AnnaLukose/EEE3088F-Project-2025-Group-37/ANNA LUKOSE (LKSANN001)/README.md

This folder relates to the following subsections of the power sub-system:
* Power switch (toggle switch)
* Type C connector and negotiator which negotiates 9V out
* 5V Out Boost converter with >90% efficency at 1A load
* 3V3 Out Buck converter with >90% efficency at 300mA load
* 2 External Load switches

To view the schematic focusing on these specific sections open: LKSANN001-Schematic.png

Alternatively, to view and edit the actual schematic:
1) Copy the schematic file onto your local system:
```
wget "https://github.com/AnnaLukose/EEE3088F-Project-2025-Group-37/blob/main/ANNA%20LUKOSE%20(LKSANN001)/LKSANN001.kicad_sch"
```
Or use any other relevant means

2) Open the file using KiCad's Schematic Editor
