AnnaLukose/EEE3088F-Project-2025-Group-37/ANNA LUKOSE (LKSANN001)/LKSANN001-Schematic.png

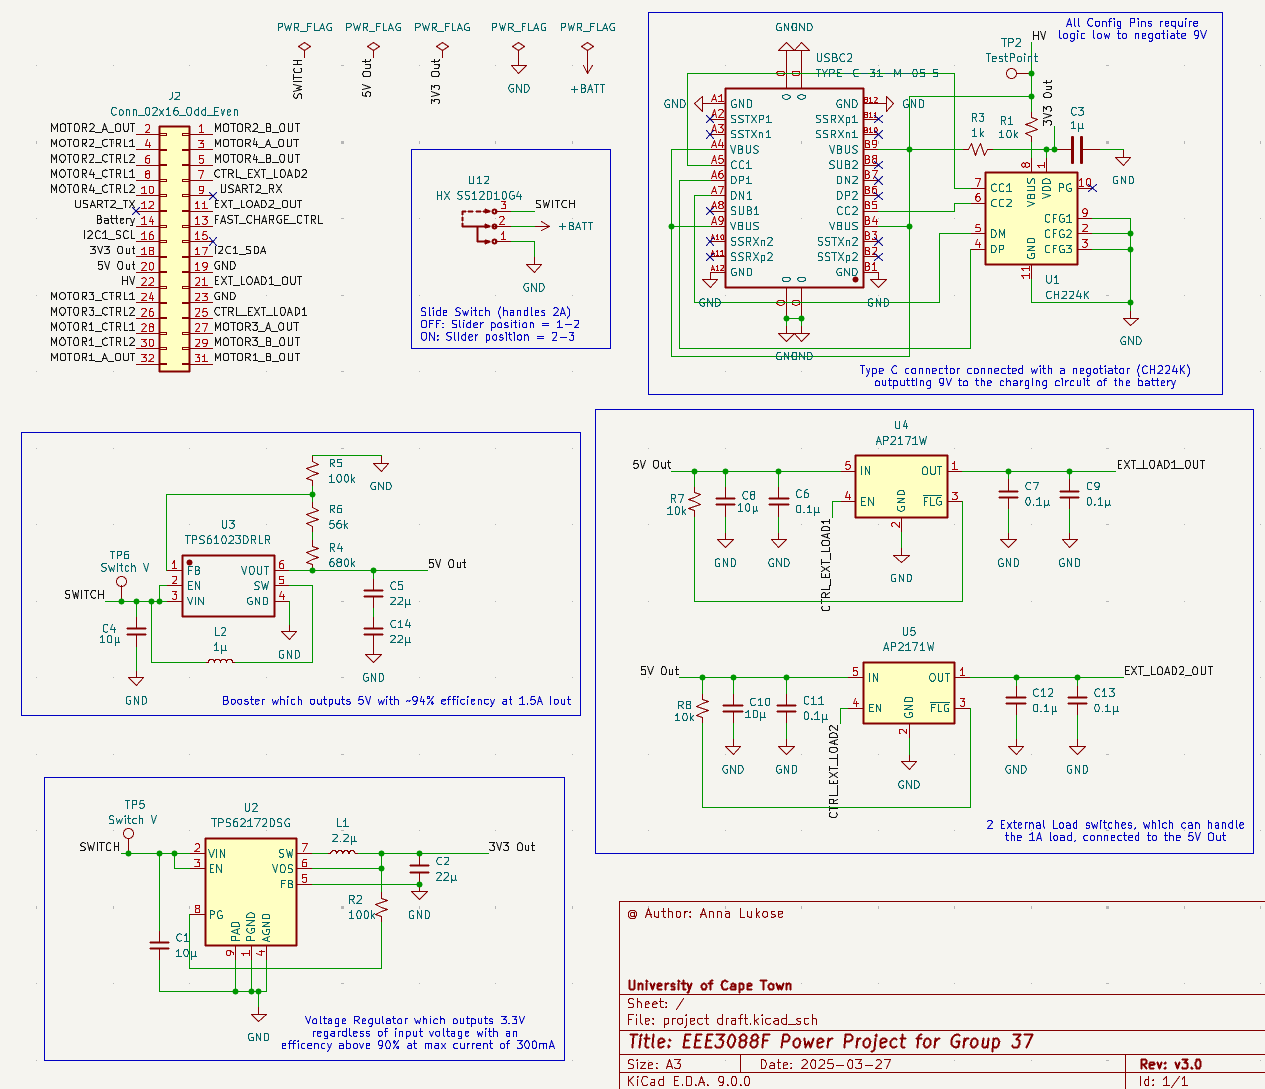
ANNA LUKOSE (LKSANN001)/LKSANN001-Schematic.png
