AnnaLukose/EEE3088F-Project-2025-Group-37/KICAD FILES/jlcpcb/production_files/EEE3088F_Project_JLCPCBBOM_LKSANN001_SNGMIS005.png

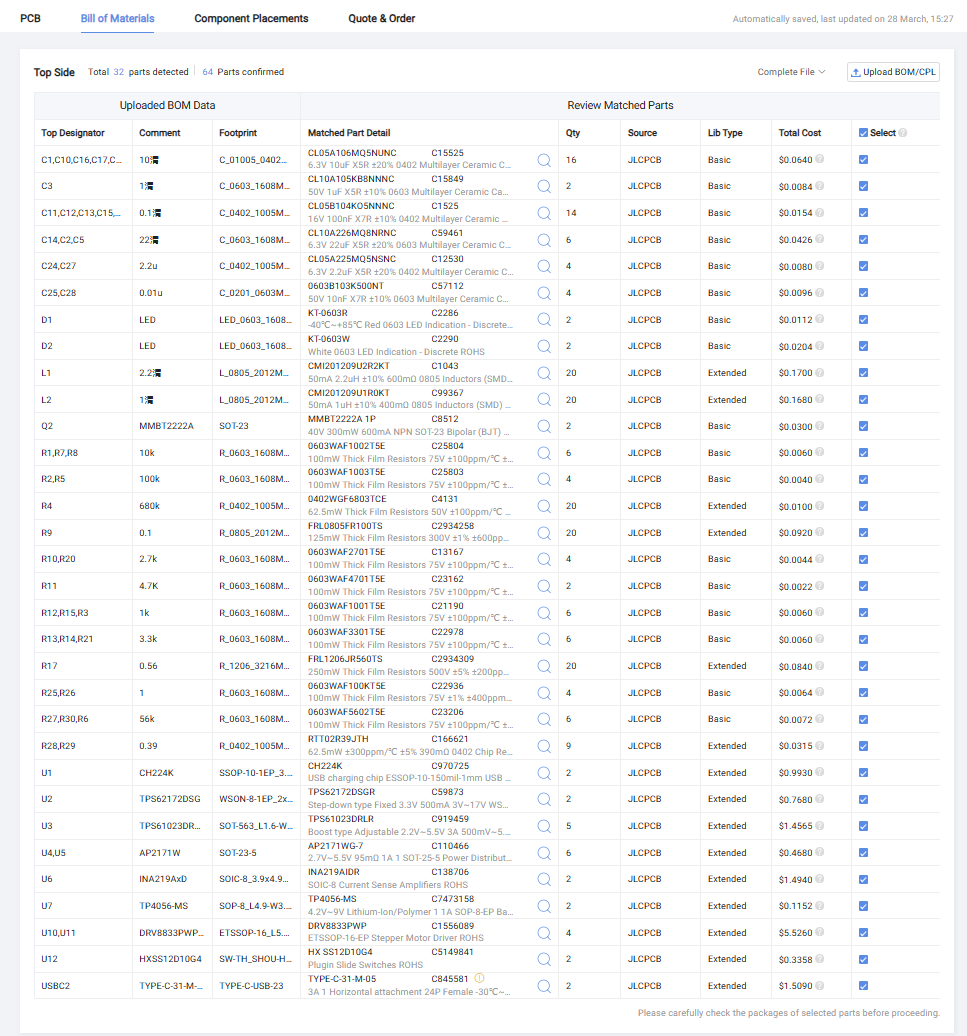
KICAD FILES/jlcpcb/production_files/EEE3088F_Project_JLCPCBBOM_LKSANN001_SNGMIS005.png
