AnnaLukose/EEE3088F-Project-2025-Group-37/KICAD FILES/jlcpcb/production_files/JLCPCB Quote.png

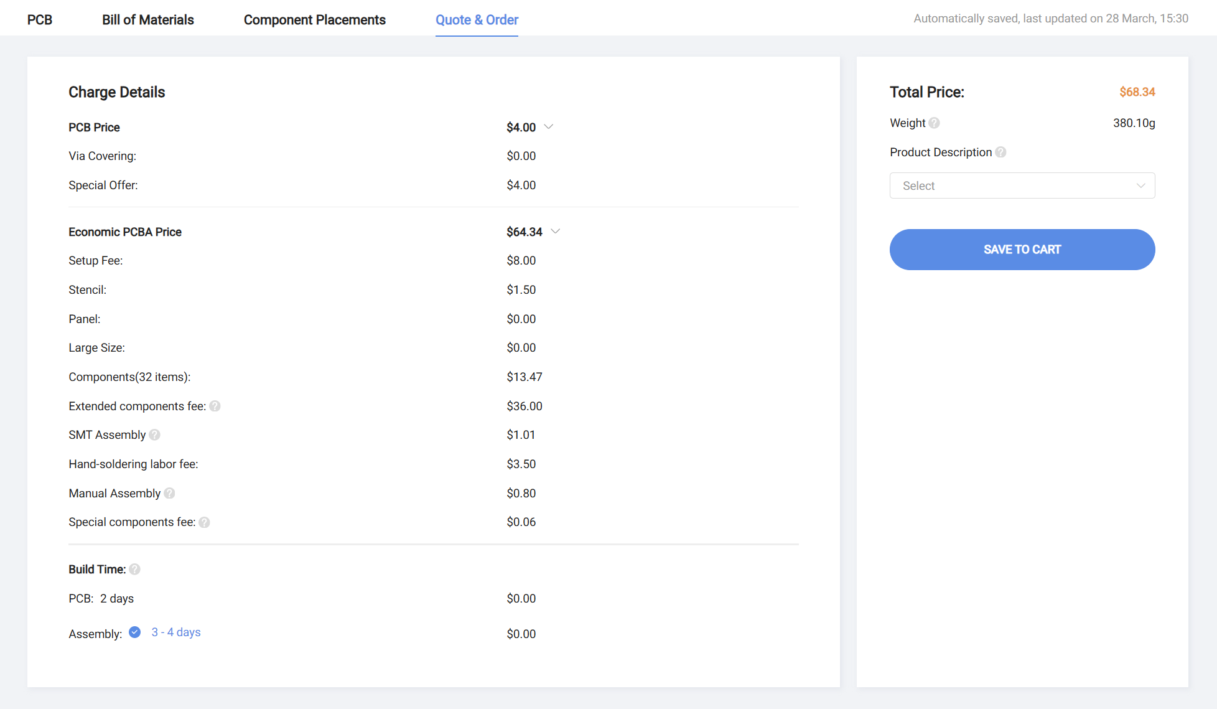
KICAD FILES/jlcpcb/production_files/JLCPCB Quote.png
