AnnaLukose/EEE3088F-Project-2025-Group-37/Schematic.pdf

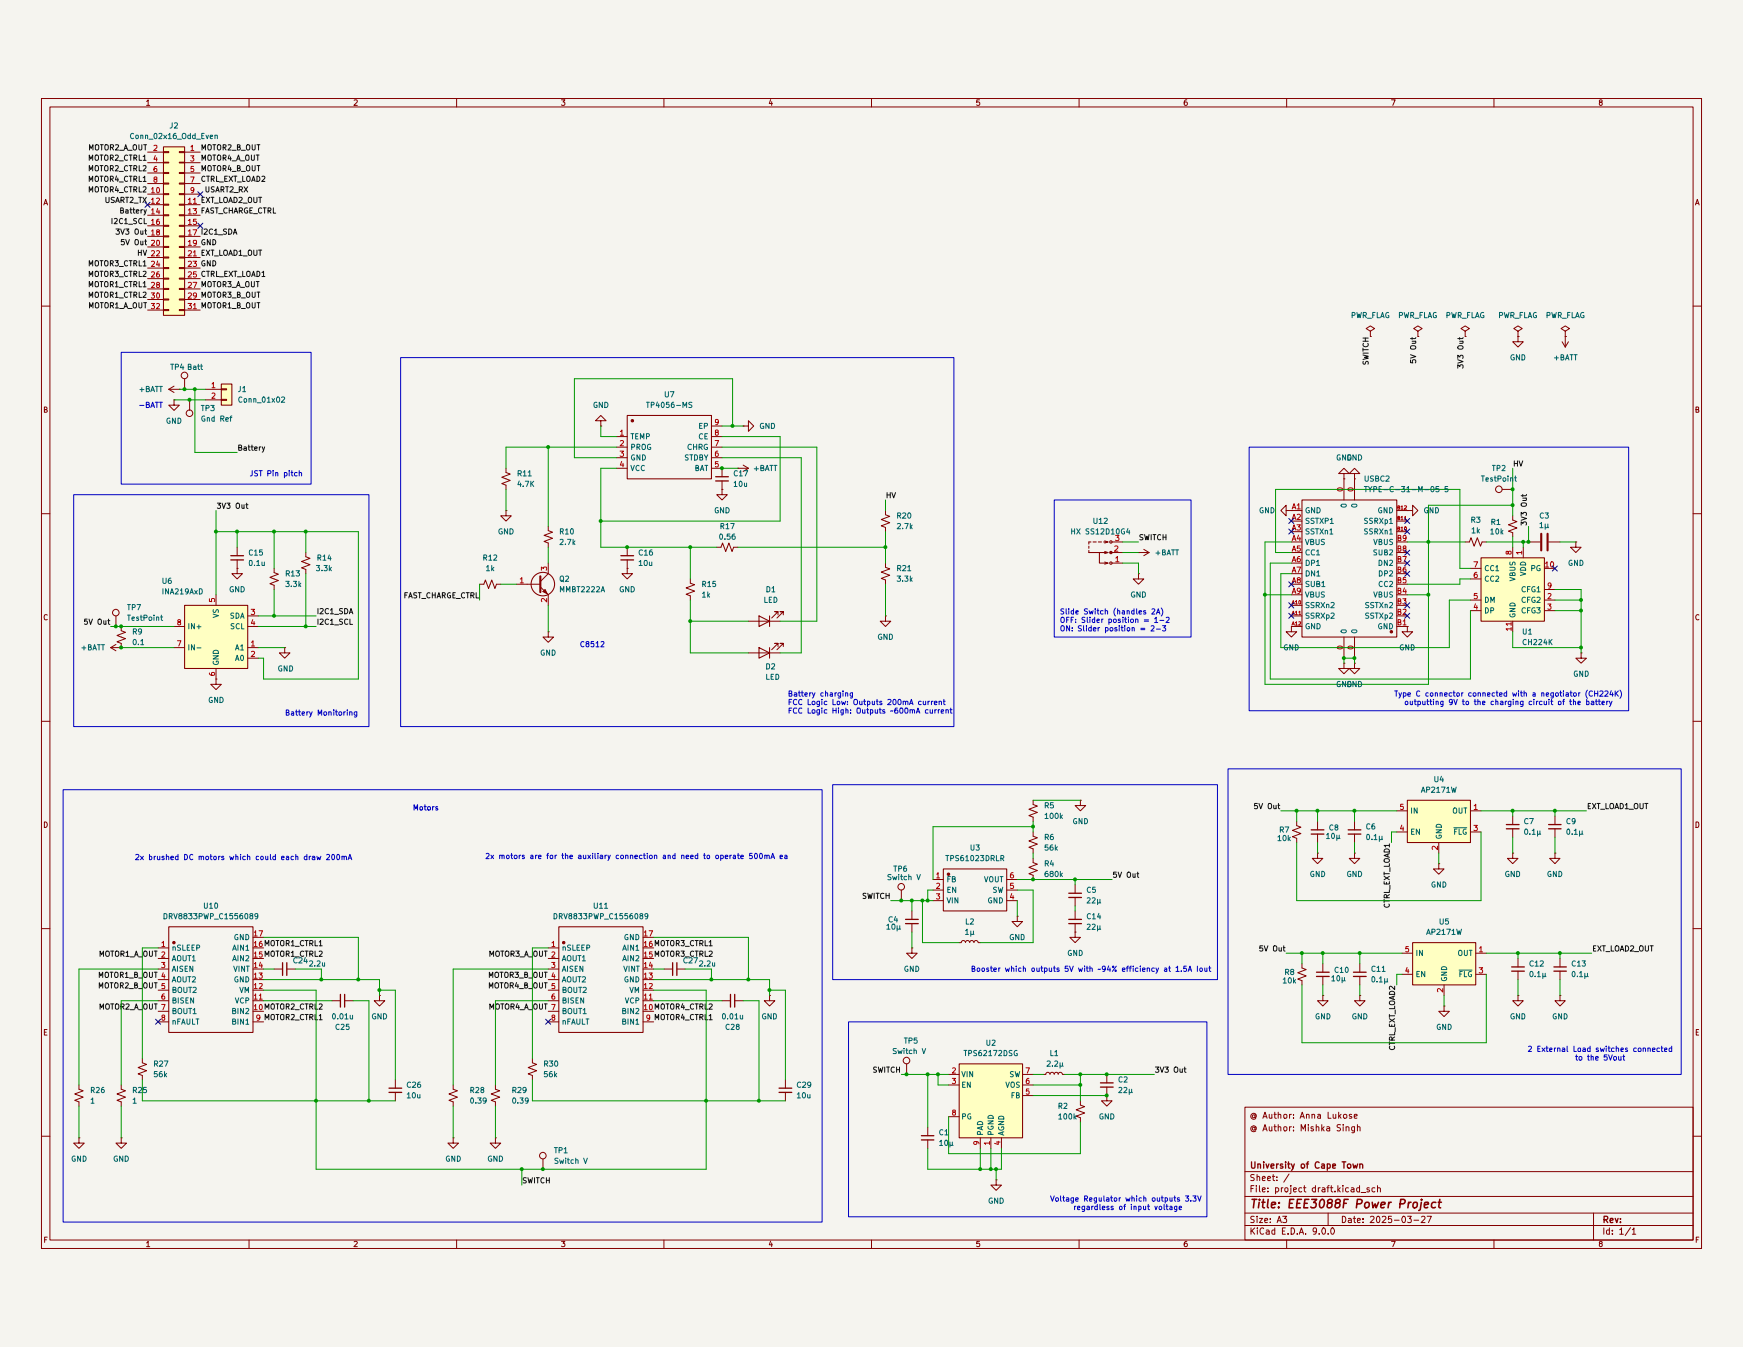
[picture p6: page 1]
