AnnaLukose/EEE3088F-Project-2025-Group-37/MISHKA SINGH (SNGMIS005)/schematic.pdf

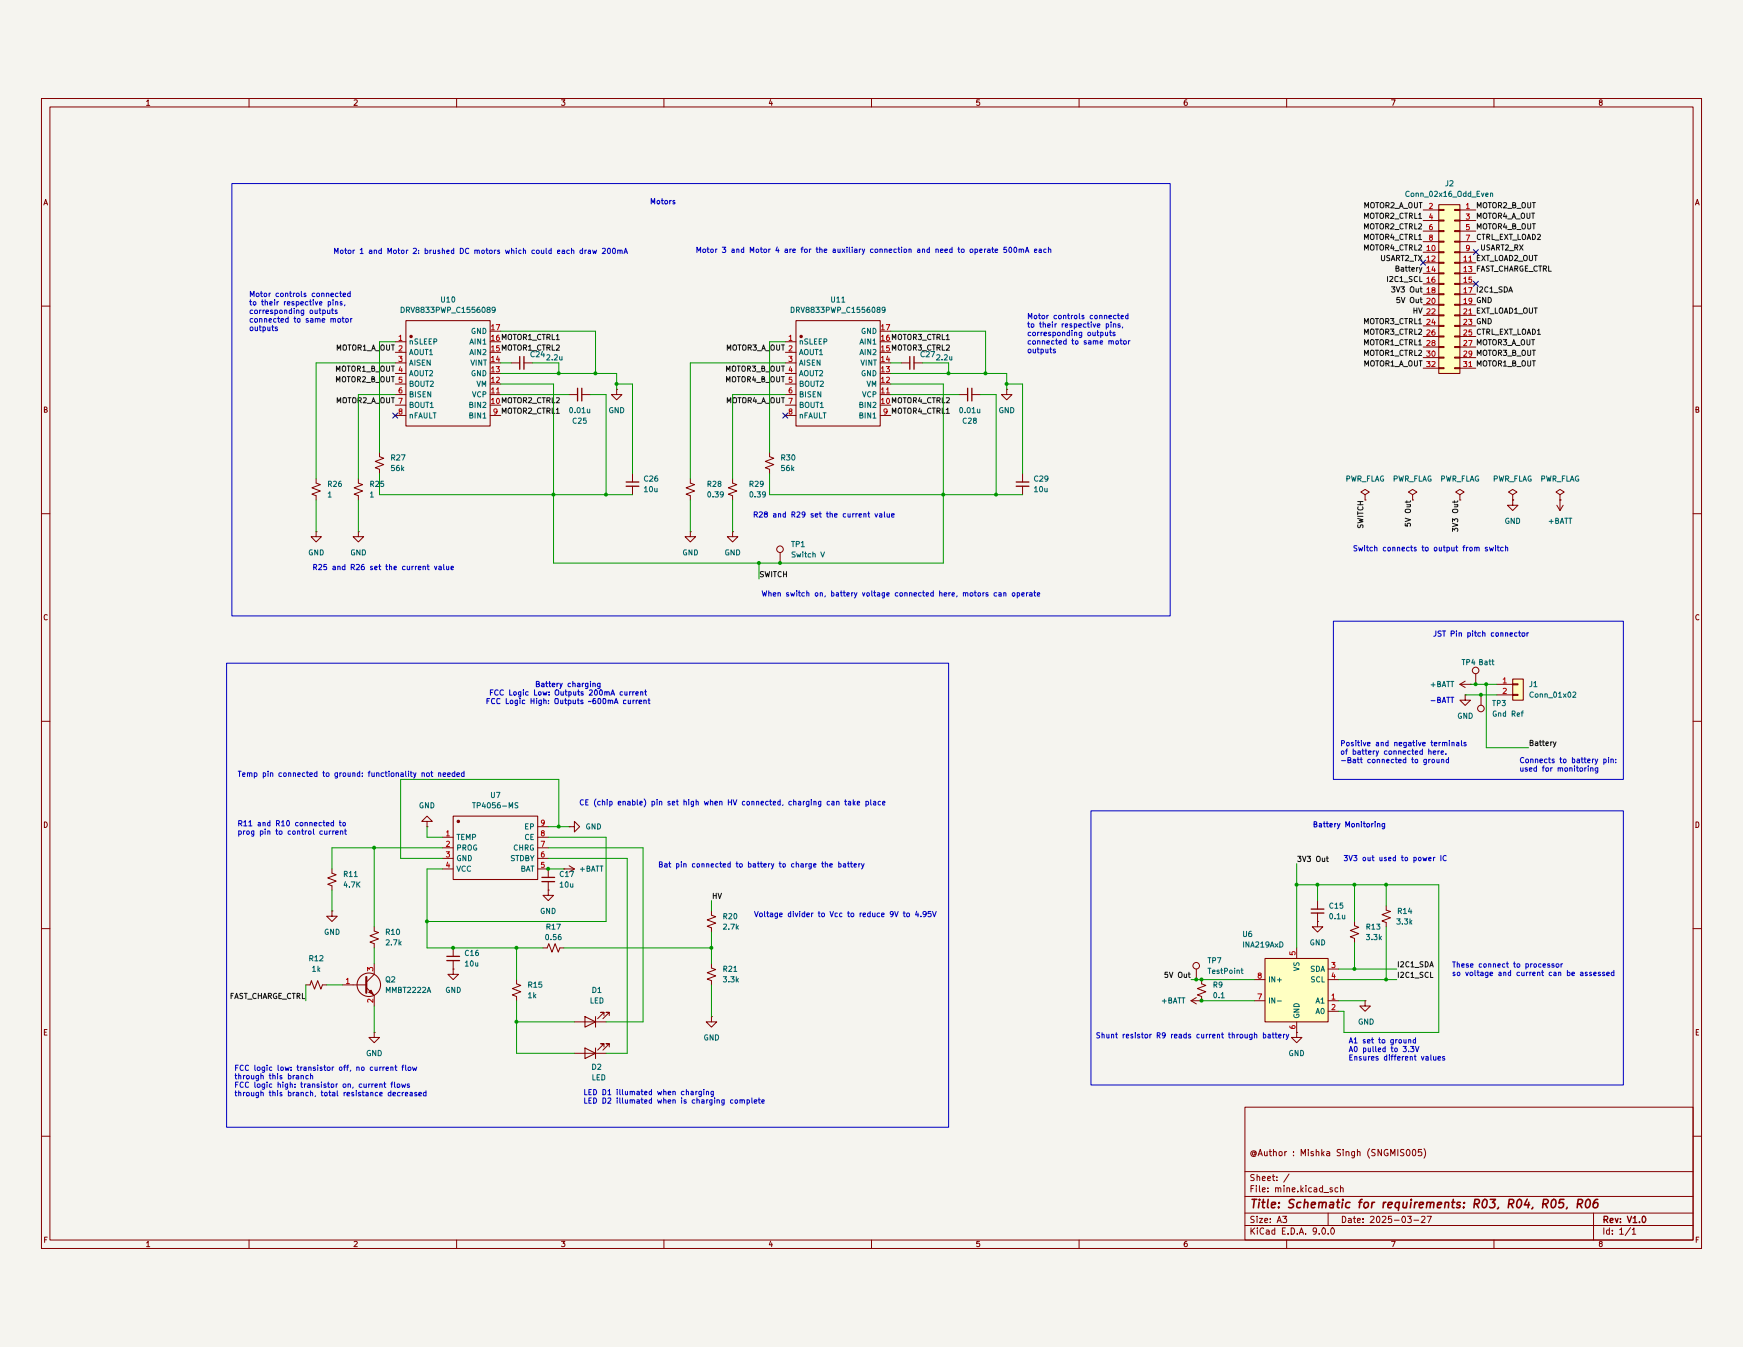
[picture p7: page 1]
