AnnaLukose/EEE3088F-Project-2025-Group-37/MISHKA SINGH (SNGMIS005)/mine/mine.kicad_pcb

## KiCad design KiCad/motor_trotten/motor_trotten.kicad_sch

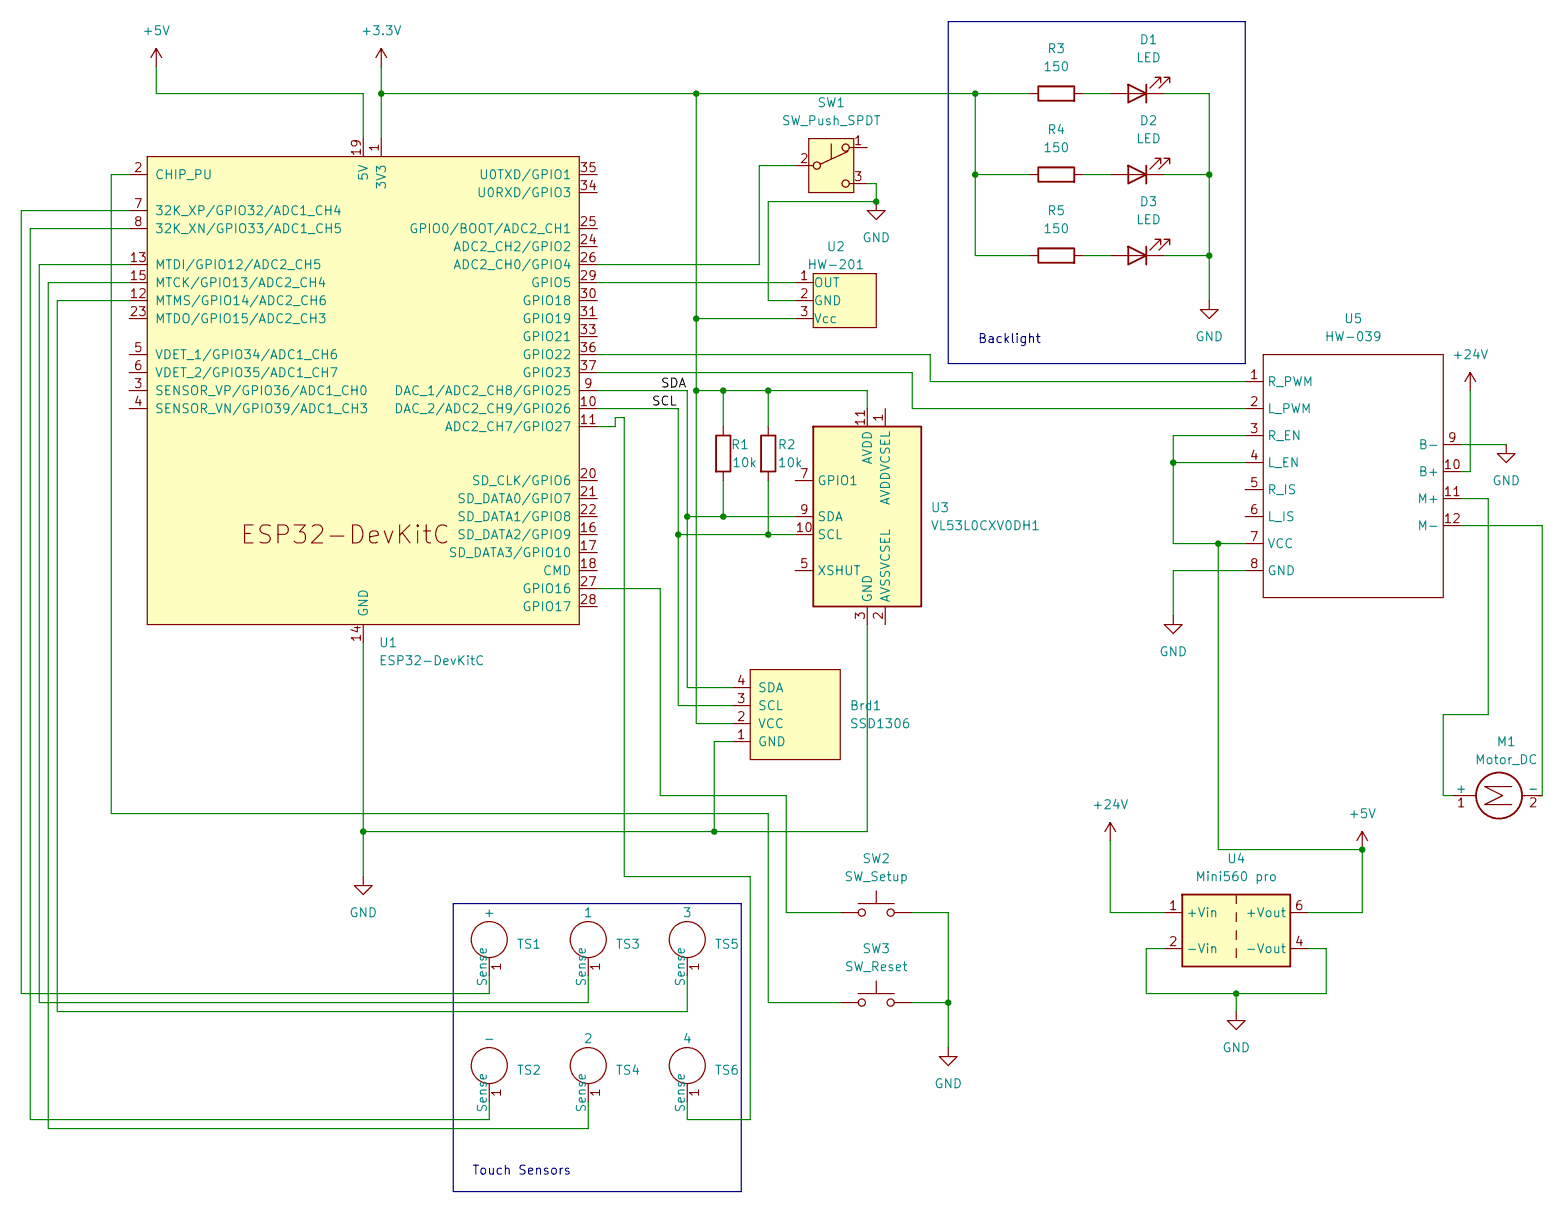
[picture p8: schematic motor_trotten.kicad_sch]

Parts:
Brd1: SSD1306
D1, D2, D3: LED
M1: Motor_DC
R1, R2: 10k
R3, R4, R5: 150
SW1: SW_Push_SPDT
SW2: SW_Setup
SW3: SW_Reset
TS1, TS2, TS3, TS4, TS5, TS6: (no value)
U1: ESP32-DevKitC
U2: HW-201
U3: VL53L0CXV0DH1; ST_VL53L1x
U4: Mini560 pro; Converter_DCDC_TRACO_TBA2-xxxx_Single_THT
U5: HW-039

Connections:
+3.3V: Brd1.2 (VCC), R1.1, R2.1, R3.1, R4.1, R5.1, U1.1 (3V3), U2.3 (Vcc), U3.11 (AVDD)
+5V: U1.19 (5V), U4.6 (+Vout), U5.3 (R_EN), U5.4 (L_EN), U5.7 (VCC)
+24V: U4.1 (+Vin), U5.10 (B+)
GND: Brd1.1 (GND), D1.1 (K), D2.1 (K), D3.1 (K), SW1.3 (C), SW2.2, SW3.2, U1.14 (GND), U1.32 (GND), U1.38 (GND), U2.2 (GND), U3.3 (GND), U3.4 (GND), U3.6 (GND), U3.12 (GND), U4.2 (-Vin), U4.4 (-Vout), U5.8 (GND), U5.9 (B-)
unnamed: D1.2 (A), R3.2
unnamed: D2.2 (A), R4.2
unnamed: D3.2 (A), R5.2
unnamed: M1.1 (+), U5.11 (M+)
unnamed: M1.2 (-), U5.12 (M-)
unnamed: SW1.2 (B), U1.26 (ADC2_CH0/GPIO4)
unnamed: SW2.1, U1.27 (GPIO16)
unnamed: SW3.1, U1.2 (CHIP_PU)
unnamed: TS1.1, U1.7 (32K_XP/GPIO32/ADC1_CH4)
unnamed: TS2.1, U1.8 (32K_XN/GPIO33/ADC1_CH5)
unnamed: TS3.1, U1.13 (MTDI/GPIO12/ADC2_CH5)
unnamed: TS4.1, U1.15 (MTCK/GPIO13/ADC2_CH4)
unnamed: TS5.1, U1.12 (MTMS/GPIO14/ADC2_CH6)
unnamed: TS6.1, U1.11 (ADC2_CH7/GPIO27)
unnamed: U1.29 (GPIO5), U2.1 (OUT)
unnamed: U1.36 (GPIO22), U5.1 (R_PWM)
unnamed: U1.37 (GPIO23), U5.2 (L_PWM)
SCL: Brd1.3 (SCL), R2.2, U1.10 (DAC_2/ADC2_CH9/GPIO26), U3.10 (SCL)
SDA: Brd1.4 (SDA), R1.2, U1.9 (DAC_1/ADC2_CH8/GPIO25), U3.9 (SDA)

Notes on the sheet:
Backlight
Touch Sensors
