AnnaLukose/EEE3088F-Project-2025-Group-37/(commit log)

2025-04-21 Added schematic
2025-04-22 Added kicad files
    [BOM-project draft.csv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]
2025-05-15 Added indiviual folders
    [mine.kicad_pcb, mine.kicad_sch]
2025-05-17 Added LKSANN001 Schematic
